Mikky100/ASkompu/docs/releases/0.1.2.md

# ASkompu 0.1.2 — Verified prototype

Release baseline: the latest implementation produced in the Codex conversation,
not the older 0.1.0 tree used accidentally for 0.1.1.

## Included GitHub issues

- #6: JAT+ULA/MLA first-interval timing at the accepted departure time
- #7: power button disabled by default for each session and display shutdown
- #8: trip presentation precision selected by speed with hysteresis
- #9: pulse input diagnostics, history and USB report
- #10: faster foot-reset response (5 ms software debounce)
- #11: one wrapping route-order continuation choice
- #12: move display shutdown to the main menu after System (sub-issue of #7)

The #7 shutdown placement is intentionally changed from the original issue:
`SAMMUTA NAYTTO` is the last main-menu item, immediately after `JARJESTELMA`.
Opening the main menu with Up selects it first. The button-settings submenu only
contains the session-local physical power-button enable/disable choice.

## Verification

- Native PlatformIO tests: 147/147 passed
- `esp32s3-ili9488-main`: build passed
- `lilygo-main`: build passed
- The ESP32-S3/ILI9488 version was installed through COM7; every written flash
  region was hash-verified by the upload tool and the device was reset cleanly
- The user confirmed that the installed version works on the target hardware

The Verified designation records the automated tests, successful release
builds, verified flash upload and hardware-functional confirmation above. It is
not a product-safety certification or a claim of a complete competition road
test.

Verified 8 November 2026.
