Mikky100/ASkompu/ASkompu_PCB_kytkentakaavio.png

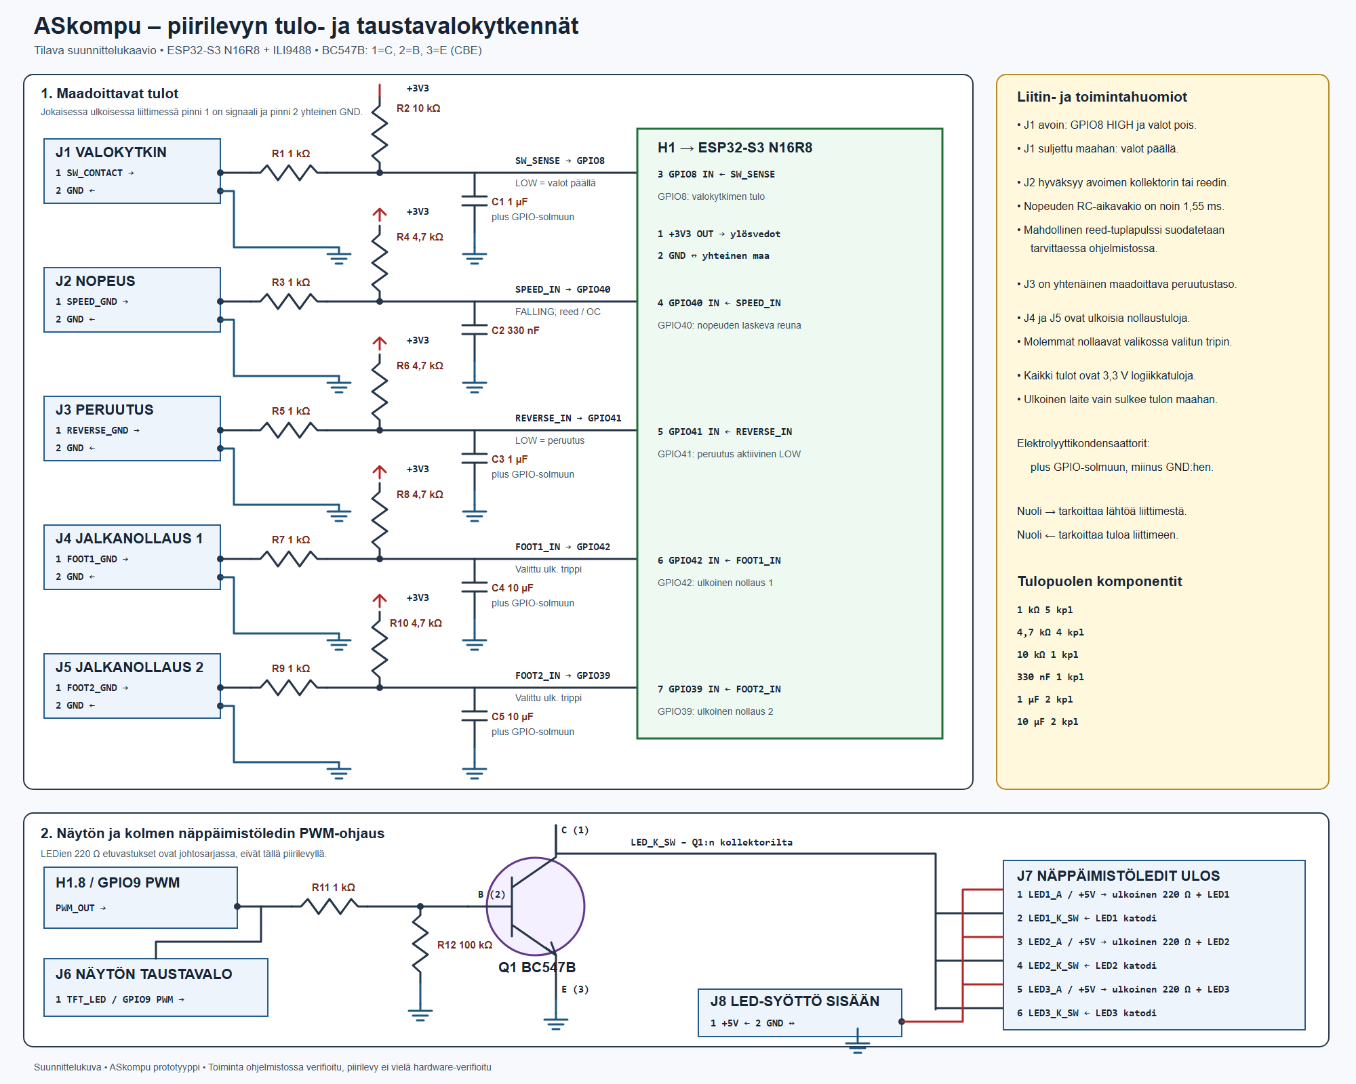
ASkompu_PCB_kytkentakaavio.png
