Mikky100/ASkompu/src/main.cpp

#include <Arduino.h>

#include "BoardConfig.h"
#include "CalibrationConfig.h"
#include "DemoConfig.h"
#include "core/ApplicationCore.h"
#include "input/DebouncedButton.h"
#include "input/PulseFilter.h"
#include "input/PulseInput.h"
#include "input/StableSignalFilter.h"
#include "ports/ArduinoClock.h"
#include "ports/PulseDiagnosticSerial.h"
#include "settings/SettingsRepository.h"
#include "settings/CompetitionProgressStore.h"
#include "settings/PreferencesRouteOrderStore.h"
#include "ui/DisplayView.h"

namespace {

constexpr uint32_t DEBOUNCE_MS = 12;
constexpr uint32_t FOOT_RESET_DEBOUNCE_MS = 5;
constexpr uint32_t POLL_INTERVAL_MS = 10;
constexpr uint32_t POINT_LONG_PRESS_MS = 2000;
constexpr uint32_t POINT_MINIMUM_PRESS_INTERVAL_MS = 500;
constexpr uint32_t REVERSE_STABILITY_MS = 20;
constexpr uint32_t LIGHT_SWITCH_STABILITY_MS = 20;
constexpr uint32_t RIGHT_MINIMUM_PRESS_INTERVAL_MS = 180;
constexpr uint32_t MAXIMUM_ACCEPTED_SPEED_KMH = 200;

input::DebouncedButton leftButton(BoardConfig::PIN_BUTTON_LEFT,
                                  BoardConfig::BUTTON_PRESSED_LEVEL,
                                  DEBOUNCE_MS,
                                  CalibrationConfig::LONG_PRESS_DELAY_MS);
input::DebouncedButton upButton(BoardConfig::PIN_BUTTON_UP,
                                BoardConfig::BUTTON_PRESSED_LEVEL,
                                DEBOUNCE_MS,
                                CalibrationConfig::LONG_PRESS_DELAY_MS,
                                CalibrationConfig::REPEAT_INTERVAL_MS);
input::DebouncedButton downButton(BoardConfig::PIN_BUTTON_DOWN,
                                  BoardConfig::BUTTON_PRESSED_LEVEL,
                                  DEBOUNCE_MS,
                                  CalibrationConfig::LONG_PRESS_DELAY_MS,
                                  CalibrationConfig::REPEAT_INTERVAL_MS);
input::DebouncedButton rightButton(BoardConfig::PIN_BUTTON_RIGHT,
                                   BoardConfig::BUTTON_PRESSED_LEVEL,
                                   DEBOUNCE_MS,
                                   CalibrationConfig::LONG_PRESS_DELAY_MS,
                                   0, RIGHT_MINIMUM_PRESS_INTERVAL_MS);
input::DebouncedButton pointButton(BoardConfig::PIN_BUTTON_POINT,
                                   BoardConfig::BUTTON_PRESSED_LEVEL,
                                   DEBOUNCE_MS, POINT_LONG_PRESS_MS, 0,
                                   POINT_MINIMUM_PRESS_INTERVAL_MS);
input::DebouncedButton atButton(BoardConfig::PIN_BUTTON_AT,
                                BoardConfig::BUTTON_PRESSED_LEVEL,
                                DEBOUNCE_MS);
input::DebouncedButton trip2ResetButton(BoardConfig::PIN_BUTTON_TRIP2_RESET,
                                        BoardConfig::BUTTON_PRESSED_LEVEL,
                                        DEBOUNCE_MS);
#ifdef ASKOMPU_HAS_TRIP1_RESET_PIN
input::DebouncedButton trip1ResetButton(BoardConfig::PIN_BUTTON_TRIP1_RESET,
                                        BoardConfig::BUTTON_PRESSED_LEVEL,
                                        DEBOUNCE_MS);
#endif
#ifdef ASKOMPU_HAS_FOOT_RESET_PIN
input::DebouncedButton footResetButton(BoardConfig::PIN_BUTTON_FOOT_RESET,
                                       BoardConfig::BUTTON_PRESSED_LEVEL,
                                       FOOT_RESET_DEBOUNCE_MS);
#endif
input::StableSignalFilter reverseFilter(REVERSE_STABILITY_MS);
#ifdef ASKOMPU_HAS_LIGHT_SWITCH_PIN
input::StableSignalFilter lightSwitchFilter(LIGHT_SWITCH_STABILITY_MS);
#endif
input::PulseInput pulseInput(BoardConfig::PIN_PULSE_INPUT,
                             BoardConfig::PULSE_INPUT_MODE,
                             BoardConfig::PULSE_INTERRUPT_MODE);

ports::ArduinoClock clockSource;
core::SoftwareClock softwareClock(clockSource);
core::ApplicationCore application(
    softwareClock, CalibrationConfig::DEFAULT_MILLIMETERS_PER_PULSE,
    DemoConfig::zeroSpeedTimeoutUs);
settings::SettingsRepository settingsRepository;
settings::CompetitionProgressStore competitionProgressStore;
settings::PreferencesRouteOrderStore routeOrderStore;
ui::DisplayView view;
uint32_t lastDisplayUpdateMs = 0;
core::Screen renderedScreen = core::Screen::StartupTimeEntry;
bool pointLongPressPending = false;
ports::PulseDiagnosticSerial pulseSerial;
bool serialResetRequested = false;
bool serialDumpRequested = false;

bool dispatchButton(input::DebouncedButton& button, core::ButtonId id,
                    uint32_t nowMs) {
  bool dispatched = false;
  if (button.consumePressedEvent()) {
    application.handleButton({id, core::ButtonEventType::Press, nowMs});
    dispatched = true;
  }
  if (button.consumeReleasedEvent()) {
    application.handleButton({id, core::ButtonEventType::Release, nowMs});
    dispatched = dispatched || id == core::ButtonId::At ||
                 application.screen() == core::Screen::Diagnostics;
  }
  if (button.consumeLongPressEvent()) {
    application.handleButton({id, core::ButtonEventType::LongStart, nowMs});
    dispatched = true;
  }
  if (button.consumeRepeatEvent()) {
    application.handleButton({id, core::ButtonEventType::LongRepeat, nowMs});
    dispatched = true;
  }
  return dispatched;
}

bool dispatchPointButton(uint32_t nowMs) {
  bool dispatched = false;
  if (pointButton.consumePressedEvent()) {
    pointLongPressPending = false;
    application.handleButton(
        {core::ButtonId::Point, core::ButtonEventType::Press, nowMs});
    dispatched = application.screen() == core::Screen::Diagnostics;
  }
  if (pointButton.consumeLongPressEvent()) {
    // Do not open the override menu while the contact is still held. Requiring
    // a stable release makes an additional-order request deliberate and keeps
    // a delayed/bounced normal point press from being interpreted as long.
    pointLongPressPending = true;
  }
  if (pointButton.consumeReleasedEvent()) {
    const bool shortPress = pointButton.consumeShortPressEvent();
    if (pointLongPressPending) {
      pointLongPressPending = false;
      application.handleButton(
          {core::ButtonId::Point, core::ButtonEventType::LongStart, nowMs});
      dispatched = true;
    } else if (shortPress) {
      application.handleButton(
          {core::ButtonId::Point, core::ButtonEventType::Release, nowMs});
      dispatched = true;
    }
  }
  return dispatched;
}

bool dispatchLeftButton(uint32_t nowMs) {
  bool dispatched = false;
  const bool diagnostics = application.screen() == core::Screen::Diagnostics;
  if (leftButton.consumePressedEvent() && diagnostics) {
    application.handleButton(
        {core::ButtonId::Left, core::ButtonEventType::Press, nowMs});
    dispatched = true;
  }
  if (leftButton.consumeLongPressEvent()) {
    application.handleButton(
        {core::ButtonId::Left, core::ButtonEventType::LongStart, nowMs});
    dispatched = true;
  }
  if (leftButton.consumeReleasedEvent()) {
    const bool shortPress = leftButton.consumeShortPressEvent();
    if (diagnostics) {
      application.handleButton(
          {core::ButtonId::Left, core::ButtonEventType::Release, nowMs});
      dispatched = true;
    } else if (shortPress) {
      application.handleButton(
          {core::ButtonId::Left, core::ButtonEventType::Press, nowMs});
      dispatched = true;
    }
  }
  return dispatched;
}

bool dispatchRightButton(uint32_t nowMs) {
  bool dispatched = false;
  const bool diagnostics = application.screen() == core::Screen::Diagnostics;
  if (rightButton.consumePressedEvent() && diagnostics) {
    application.handleButton({core::ButtonId::Right,
                              core::ButtonEventType::Press, nowMs});
    dispatched = true;
  }
  if (rightButton.consumeLongPressEvent()) {
    application.handleButton({core::ButtonId::Right,
                              core::ButtonEventType::LongStart, nowMs});
    dispatched = true;
  }
  if (rightButton.consumeReleasedEvent()) {
    const bool shortPress = rightButton.consumeShortPressEvent();
    if (diagnostics) {
      application.handleButton({core::ButtonId::Right,
                                core::ButtonEventType::Release, nowMs});
      dispatched = true;
    } else if (shortPress) {
      // Navigation is committed only after a complete, stable press/release.
      application.handleButton({core::ButtonId::Right,
                                core::ButtonEventType::Press, nowMs});
      dispatched = true;
    }
  }
  return dispatched;
}

}  // namespace

void setup() {
  Serial.begin(115200);
  Serial.printf("ASkompu 0.1.2 build %s %s\n", __DATE__, __TIME__);

  const settings::CalibrationLoadResult calibration =
      settingsRepository.loadCalibration();
  application.setInitialMillimetersPerPulse(calibration.millimetersPerPulse);
  pulseInput.setMinimumPulseIntervalUs(input::minimumPulseIntervalUs(
      calibration.millimetersPerPulse, MAXIMUM_ACCEPTED_SPEED_KMH));
  const settings::TextColorLoadResult textColor =
      settingsRepository.loadTextColor();
  application.setInitialTextColor(textColor.color);
  application.setCompetitionSettings(
      settingsRepository.loadCompetitionSettings().settings);
  application.setInitialDebugDisplaySettings(
      settingsRepository.loadDebugDisplaySettings().settings);
  application.setInitialDisplaySettings(
      settingsRepository.loadDisplaySettings().settings);
  Serial.printf("Calibration: %lu mm/pulse%s\n",
                static_cast<unsigned long>(calibration.millimetersPerPulse),
                calibration.usedDefault ? " (default)" : " (NVS)");
  domain::RouteOrder routeOrder;
  if (routeOrderStore.load(routeOrder)) {
    application.setInitialRouteOrder(
        routeOrder,
        routeOrderStore.activity() == route::RouteOrderActivity::ACTIVE);
    Serial.printf("Route order: %u segments (NVS)\n",
                  static_cast<unsigned>(routeOrder.segments.size()));
    domain::CompetitionProgressSnapshot progress;
    if (competitionProgressStore.load(progress))
      application.setInitialCompetitionProgress(progress);
  }

  leftButton.begin();
  upButton.begin();
  downButton.begin();
  rightButton.begin();
  pointButton.begin();
  atButton.begin();
  trip2ResetButton.begin();
#ifdef ASKOMPU_HAS_TRIP1_RESET_PIN
  trip1ResetButton.begin();
#endif
#ifdef ASKOMPU_HAS_FOOT_RESET_PIN
  footResetButton.begin();
#endif
#ifdef ASKOMPU_HAS_LIGHT_SWITCH_PIN
  pinMode(BoardConfig::PIN_LIGHT_SWITCH, BoardConfig::LIGHT_SWITCH_INPUT_MODE);
#endif
  pinMode(BoardConfig::PIN_REVERSE_INPUT, BoardConfig::REVERSE_INPUT_MODE);
  const uint32_t inputNowMs = clockSource.monotonicMilliseconds();
#ifdef ASKOMPU_HAS_LIGHT_SWITCH_PIN
  lightSwitchFilter.reset(
      digitalRead(BoardConfig::PIN_LIGHT_SWITCH) ==
          BoardConfig::LIGHT_SWITCH_ON_LEVEL,
      inputNowMs);
#endif
  reverseFilter.reset(
      digitalRead(BoardConfig::PIN_REVERSE_INPUT) ==
          BoardConfig::REVERSE_ACTIVE_LEVEL,
      inputNowMs);
  application.handleReverseSignal({reverseFilter.active(), inputNowMs});
  pulseInput.begin();

  const bool displayReady = view.begin();
#ifdef ASKOMPU_HAS_LIGHT_SWITCH_PIN
  view.setBacklight(application.displayOn());
#endif
#if defined(TFT_BL) && defined(TFT_BACKLIGHT_ON)
  Serial.printf("Display: buffer=%s, backlight GPIO%u=%s (read=%u)\n",
                displayReady ? "ok" : "failed",
                static_cast<unsigned>(TFT_BL),
                TFT_BACKLIGHT_ON == HIGH ? "active HIGH" : "active LOW",
                static_cast<unsigned>(digitalRead(TFT_BL)));
#else
  Serial.printf("Display: buffer=%s, no backlight GPIO\n",
                displayReady ? "ok" : "failed");
#endif
  view.render(application.displayModel());
}

void loop() {
  const uint32_t nowMs = clockSource.monotonicMilliseconds();

  leftButton.update(nowMs);
  upButton.update(nowMs);
  downButton.update(nowMs);
  rightButton.update(nowMs);
  pointButton.update(nowMs);
  atButton.update(nowMs);
  trip2ResetButton.update(nowMs);
#ifdef ASKOMPU_HAS_TRIP1_RESET_PIN
  trip1ResetButton.update(nowMs);
#endif
#ifdef ASKOMPU_HAS_FOOT_RESET_PIN
  footResetButton.update(nowMs);
#endif

#ifdef ASKOMPU_HAS_LIGHT_SWITCH_PIN
  const bool rawLightsEnabled =
      digitalRead(BoardConfig::PIN_LIGHT_SWITCH) ==
      BoardConfig::LIGHT_SWITCH_ON_LEVEL;
  if (lightSwitchFilter.update(rawLightsEnabled, nowMs))
    application.handleLightSwitch(lightSwitchFilter.active());
#endif

  if (leftButton.isPressed() || upButton.isPressed() || downButton.isPressed() ||
      rightButton.isPressed() || pointButton.isPressed() || atButton.isPressed() ||
      trip2ResetButton.isPressed()
#ifdef ASKOMPU_HAS_TRIP1_RESET_PIN
      || trip1ResetButton.isPressed()
#endif
#ifdef ASKOMPU_HAS_FOOT_RESET_PIN
      || footResetButton.isPressed()
#endif
      )
    application.wakeDisplay();

  const bool rawReverse =
      digitalRead(BoardConfig::PIN_REVERSE_INPUT) ==
      BoardConfig::REVERSE_ACTIVE_LEVEL;
  if (reverseFilter.update(rawReverse, nowMs))
    application.handleReverseSignal({reverseFilter.active(), nowMs});

  for (uint8_t index = 0; index < 8 && Serial.available(); ++index) {
    const char command = Serial.read();
    if (command == 'p') serialDumpRequested = true;
    if (command == 'r') serialResetRequested = true;
  }
  const bool resetDiagnostics =
      serialResetRequested || application.takePulseDiagnosticsResetRequest();
  serialResetRequested = false;
  if (resetDiagnostics) pulseSerial.cancel();
  const input::PulseSnapshot pulseSnapshot =
      pulseInput.consumeSnapshot(resetDiagnostics);
  const uint32_t nowUs = clockSource.monotonicMicroseconds();

  bool inputDispatched = false;
  inputDispatched |= dispatchLeftButton(nowMs);
  inputDispatched |= dispatchButton(upButton, core::ButtonId::Up, nowMs);
  inputDispatched |= dispatchButton(downButton, core::ButtonId::Down, nowMs);
  inputDispatched |= dispatchRightButton(nowMs);
  inputDispatched |= dispatchPointButton(nowMs);
  inputDispatched |= dispatchButton(atButton, core::ButtonId::At, nowMs);
  inputDispatched |=
      dispatchButton(trip2ResetButton, core::ButtonId::Trip2Reset, nowMs);
#ifdef ASKOMPU_HAS_TRIP1_RESET_PIN
  inputDispatched |=
      dispatchButton(trip1ResetButton, core::ButtonId::Trip1Reset, nowMs);
#endif
#ifdef ASKOMPU_HAS_FOOT_RESET_PIN
  inputDispatched |=
      dispatchButton(footResetButton, core::ButtonId::FootReset, nowMs);
#endif

  application.handleDistancePulses(
      {pulseSnapshot.pendingPulses, pulseSnapshot.previousPulseAtUs,
       pulseSnapshot.lastPulseAtUs, nowUs, reverseFilter.active()});
  if (!resetDiagnostics)
    pulseInput.recordDelivered(pulseSnapshot.pendingPulses);
  application.tick(nowUs);
  if (serialDumpRequested || application.takePulseDiagnosticsDumpRequest()) {
    serialDumpRequested = false;
    pulseSerial.capture(
        pulseInput, application.millimetersPerPulse(),
        BoardConfig::PIN_PULSE_INPUT,
        BoardConfig::PULSE_INTERRUPT_MODE == FALLING);
  }
  pulseSerial.service();
  const input::PulseDiagnosticsSnapshot pulseDiagnostics =
      pulseInput.diagnostics();
  application.setPulseDiagnostics(
      pulseDiagnostics,
      pulseDiagnostics.hasAccepted
          ? micros() - pulseDiagnostics.lastAcceptedUs
          : 0,
      BoardConfig::PIN_PULSE_INPUT,
      BoardConfig::PULSE_INTERRUPT_MODE == FALLING);

  bool progressRestored = false;
  if (application.takeCompetitionProgressRestoreResult(progressRestored))
    Serial.printf("Competition progress restore: %s\n",
                  progressRestored ? "ok" : "rejected; started from route");

  uint32_t calibrationToSave = 0;
  if (application.takeCalibrationSaveRequest(calibrationToSave)) {
    const bool saved = settingsRepository.saveCalibration(calibrationToSave);
    application.completeCalibrationSave(saved);
    if (saved) {
      pulseInput.setMinimumPulseIntervalUs(input::minimumPulseIntervalUs(
          calibrationToSave, MAXIMUM_ACCEPTED_SPEED_KMH));
      Serial.printf("Saved calibration: %lu mm/pulse\n",
                    static_cast<unsigned long>(calibrationToSave));
    }
  }

  domain::TextColor textColorToSave = domain::TextColor::WHITE;
  if (application.takeTextColorSaveRequest(textColorToSave)) {
    application.completeTextColorSave(
        settingsRepository.saveTextColor(textColorToSave));
  }

  domain::DebugDisplaySettings debugSettingsToSave;
  if (application.takeDebugDisplaySettingsSaveRequest(debugSettingsToSave)) {
    application.completeDebugDisplaySettingsSave(
        settingsRepository.saveDebugDisplaySettings(debugSettingsToSave));
  }

  domain::DisplaySettings displaySettingsToSave;
  if (application.takeDisplaySettingsSaveRequest(displaySettingsToSave)) {
    application.completeDisplaySettingsSave(
        settingsRepository.saveDisplaySettings(displaySettingsToSave));
  }

  const domain::RouteOrder* orderToSave = nullptr;
  if (application.takeRouteOrderSaveRequest(orderToSave)) {
    const bool saved = orderToSave && routeOrderStore.replace(*orderToSave);
    application.completeRouteOrderSave(saved);
    Serial.printf("Route order save: %s\n", saved ? "ok" : "failed");
  }
  if (application.takeRouteOrderCompletionRequest()) {
    application.completeRouteOrderCompletion(routeOrderStore.markCompleted());
  }
  if (application.takeCompetitionProgressClearRequest())
    competitionProgressStore.clear();
  domain::CompetitionProgressSnapshot progress;
  if (application.takeCompetitionProgressSaveRequest(progress))
    competitionProgressStore.save(progress);

  const core::DisplayModel displayModel = application.displayModel();
  view.setBacklight(displayModel.displayOn);
  const bool screenChanged = displayModel.screen != renderedScreen;
  const bool periodicScreen =
      displayModel.screen == core::Screen::BasicView ||
      displayModel.screen == core::Screen::JatResult ||
      displayModel.screen == core::Screen::StartTimeEdit ||
      displayModel.screen == core::Screen::Diagnostics ||
      displayModel.screen == core::Screen::PulseDiagnostics;
  const uint32_t periodicIntervalMs =
      (displayModel.screen == core::Screen::Diagnostics ||
       displayModel.screen == core::Screen::PulseDiagnostics)
          ? 2000UL
          : BoardConfig::DISPLAY_UPDATE_INTERVAL_MS;
  if (inputDispatched || screenChanged ||
      (periodicScreen &&
       nowMs - lastDisplayUpdateMs >= periodicIntervalMs)) {
    view.render(displayModel);
    renderedScreen = displayModel.screen;
    lastDisplayUpdateMs = nowMs;
  }
  delay(POLL_INTERVAL_MS);
}
