Mikky100/ASkompu/src/domain/MotionMath.cpp

#include "MotionMath.h"

#include <limits>

namespace domain {
namespace motion {

uint64_t distanceMillimetersForPulses(uint32_t pulses,
                                      uint32_t millimetersPerPulse) {
  return static_cast<uint64_t>(pulses) *
         static_cast<uint64_t>(millimetersPerPulse);
}

uint64_t saturatingAdd(uint64_t current, uint64_t increment) {
  const uint64_t maximum = std::numeric_limits<uint64_t>::max();
  return increment > maximum - current ? maximum : current + increment;
}

int64_t saturatingAddSigned(int64_t current, int64_t delta) {
  if (delta > 0 && current > std::numeric_limits<int64_t>::max() - delta)
    return std::numeric_limits<int64_t>::max();
  if (delta < 0 && current < std::numeric_limits<int64_t>::min() - delta)
    return std::numeric_limits<int64_t>::min();
  return current + delta;
}

float speedKmhFromPulseInterval(uint32_t millimetersPerPulse,
                                uint32_t intervalUs) {
  if (intervalUs == 0) {
    return 0.0F;
  }
  return static_cast<float>(millimetersPerPulse) * 3600.0F /
         static_cast<float>(intervalUs);
}

bool elapsedAtLeast(uint32_t now, uint32_t since, uint32_t duration) {
  return now - since >= duration;
}

}  // namespace motion
}  // namespace domain
