Mikky100/ASkompu/src/settings/SettingsRepository.cpp

#include "SettingsRepository.h"

#include <Preferences.h>

#include "CalibrationConfig.h"
#include "domain/CalibrationSetting.h"

namespace settings {
namespace {

constexpr char PREFERENCES_NAMESPACE[] = "askompu";
constexpr char SCHEMA_VERSION_KEY[] = "schemaVersion";
constexpr char CALIBRATION_KEY[] = "mmPerPulseFixed";
constexpr char TEXT_COLOR_KEY[] = "textColor";
constexpr char LATE_FACTOR_KEY[] = "lateFactor";
constexpr char EARLY_FACTOR_KEY[] = "earlyFactor";
constexpr char JAT_RESULT_SECONDS_KEY[] = "jatResultSec";
constexpr char AT_DISPLAY_DISTANCE_KEY[] = "atDistanceM";
constexpr char DEBUG_DISPLAY_ELEMENTS_KEY[] = "debugDisplay";
constexpr char BACKLIGHT_PERCENT_KEY[] = "backlight";
constexpr char SHOW_LABELS_KEY[] = "showLabels";
constexpr char MENU_FONT_SIZE_KEY[] = "menuFont";
constexpr char TRIP_DISPLAY_MODE_KEY[] = "tripDisplay";
constexpr char EXTERNAL_RESET_TARGET_KEY[] = "extTripReset";
constexpr char INTERNAL_RESET_TARGET_KEY[] = "intTripReset";

}  // namespace

CalibrationLoadResult SettingsRepository::loadCalibration() const {
  Preferences preferences;
  if (!preferences.begin(PREFERENCES_NAMESPACE, true)) {
    return {CalibrationConfig::DEFAULT_MILLIMETERS_PER_PULSE, true};
  }

  const uint16_t schemaVersion = preferences.getUShort(SCHEMA_VERSION_KEY, 0);
  const uint32_t storedValue = preferences.getUInt(CALIBRATION_KEY, 0);
  preferences.end();

  const bool valid =
      (schemaVersion == 1 || schemaVersion == 2 ||
       schemaVersion == CalibrationConfig::SETTINGS_SCHEMA_VERSION) &&
      domain::calibration::isValid(storedValue);
  return {valid ? storedValue
                : CalibrationConfig::DEFAULT_MILLIMETERS_PER_PULSE,
          !valid};
}

TextColorLoadResult SettingsRepository::loadTextColor() const {
  Preferences preferences;
  if (!preferences.begin(PREFERENCES_NAMESPACE, true)) {
    return {domain::TextColor::WHITE, true};
  }
  const uint16_t schemaVersion = preferences.getUShort(SCHEMA_VERSION_KEY, 0);
  const domain::TextColor color = static_cast<domain::TextColor>(
      preferences.getUChar(TEXT_COLOR_KEY,
                           static_cast<uint8_t>(domain::TextColor::WHITE)));
  preferences.end();
  const bool valid =
      (schemaVersion == 2 ||
       schemaVersion == CalibrationConfig::SETTINGS_SCHEMA_VERSION) &&
      domain::isValidTextColor(color);
  return {valid ? color : domain::TextColor::WHITE, !valid};
}

bool SettingsRepository::saveTextColor(domain::TextColor color) const {
  if (!domain::isValidTextColor(color)) return false;
  Preferences preferences;
  if (!preferences.begin(PREFERENCES_NAMESPACE, false)) return false;
  const bool schemaWritten =
      preferences.putUShort(SCHEMA_VERSION_KEY,
                            CalibrationConfig::SETTINGS_SCHEMA_VERSION) ==
      sizeof(uint16_t);
  const bool colorWritten =
      preferences.putUChar(TEXT_COLOR_KEY, static_cast<uint8_t>(color)) ==
      sizeof(uint8_t);
  preferences.end();
  return schemaWritten && colorWritten;
}

bool SettingsRepository::saveCalibration(uint32_t millimetersPerPulse) const {
  if (!domain::calibration::isValid(millimetersPerPulse)) {
    return false;
  }

  Preferences preferences;
  if (!preferences.begin(PREFERENCES_NAMESPACE, false)) {
    return false;
  }

  const bool alreadyStored =
      preferences.getUShort(SCHEMA_VERSION_KEY, 0) ==
          CalibrationConfig::SETTINGS_SCHEMA_VERSION &&
      preferences.getUInt(CALIBRATION_KEY, 0) == millimetersPerPulse;
  if (alreadyStored) {
    preferences.end();
    return true;
  }

  const bool schemaWritten =
      preferences.putUShort(SCHEMA_VERSION_KEY,
                            CalibrationConfig::SETTINGS_SCHEMA_VERSION) ==
      sizeof(uint16_t);
  const bool calibrationWritten =
      preferences.putUInt(CALIBRATION_KEY, millimetersPerPulse) ==
      sizeof(uint32_t);
  preferences.end();
  return schemaWritten && calibrationWritten;
}

CompetitionSettingsLoadResult SettingsRepository::loadCompetitionSettings()
    const {
  Preferences preferences;
  if (!preferences.begin(PREFERENCES_NAMESPACE, true))
    return {domain::CompetitionSettings{}, true};
  const uint16_t schemaVersion = preferences.getUShort(SCHEMA_VERSION_KEY, 0);
  domain::CompetitionSettings loaded;
  bool usedDefault = schemaVersion != CalibrationConfig::SETTINGS_SCHEMA_VERSION;
  if (!usedDefault) {
    loaded.lateFactor = preferences.getUShort(LATE_FACTOR_KEY, 1);
    loaded.earlyFactor = preferences.getUShort(EARLY_FACTOR_KEY, 3);
    loaded.jatResultSeconds = preferences.getUChar(JAT_RESULT_SECONDS_KEY, 5);
    loaded.atDisplayDistanceM =
        preferences.getUChar(AT_DISPLAY_DISTANCE_KEY, 10);
  }
  preferences.end();
  const domain::CompetitionSettings validated =
      domain::validatedCompetitionSettings(loaded);
  usedDefault = usedDefault || validated.lateFactor != loaded.lateFactor ||
                validated.earlyFactor != loaded.earlyFactor ||
                validated.jatResultSeconds != loaded.jatResultSeconds ||
                validated.atDisplayDistanceM != loaded.atDisplayDistanceM;
  return {validated, usedDefault};
}

bool SettingsRepository::saveCompetitionSettings(
    const domain::CompetitionSettings& settings) const {
  const domain::CompetitionSettings validated =
      domain::validatedCompetitionSettings(settings);
  if (validated.lateFactor != settings.lateFactor ||
      validated.earlyFactor != settings.earlyFactor ||
      validated.jatResultSeconds != settings.jatResultSeconds ||
      validated.atDisplayDistanceM != settings.atDisplayDistanceM)
    return false;
  Preferences preferences;
  if (!preferences.begin(PREFERENCES_NAMESPACE, false)) return false;
  bool ok = true;
  if (preferences.getUShort(SCHEMA_VERSION_KEY, 0) !=
      CalibrationConfig::SETTINGS_SCHEMA_VERSION)
    ok = preferences.putUShort(SCHEMA_VERSION_KEY,
                               CalibrationConfig::SETTINGS_SCHEMA_VERSION) ==
         sizeof(uint16_t);
  if (ok && preferences.getUShort(LATE_FACTOR_KEY, 0) != validated.lateFactor)
    ok = preferences.putUShort(LATE_FACTOR_KEY, validated.lateFactor) ==
         sizeof(uint16_t);
  if (ok && preferences.getUShort(EARLY_FACTOR_KEY, 0) != validated.earlyFactor)
    ok = preferences.putUShort(EARLY_FACTOR_KEY, validated.earlyFactor) ==
         sizeof(uint16_t);
  if (ok && preferences.getUChar(JAT_RESULT_SECONDS_KEY, 0xFF) !=
                validated.jatResultSeconds)
    ok = preferences.putUChar(JAT_RESULT_SECONDS_KEY,
                              validated.jatResultSeconds) == sizeof(uint8_t);
  if (ok && preferences.getUChar(AT_DISPLAY_DISTANCE_KEY, 0xFF) !=
                validated.atDisplayDistanceM)
    ok = preferences.putUChar(AT_DISPLAY_DISTANCE_KEY,
                              validated.atDisplayDistanceM) == sizeof(uint8_t);
  preferences.end();
  return ok;
}

DebugDisplaySettingsLoadResult SettingsRepository::loadDebugDisplaySettings()
    const {
  Preferences preferences;
  if (!preferences.begin(PREFERENCES_NAMESPACE, true))
    return {domain::DebugDisplaySettings{}, true};
  const uint16_t schemaVersion = preferences.getUShort(SCHEMA_VERSION_KEY, 0);
  const uint16_t stored =
      preferences.getUShort(DEBUG_DISPLAY_ELEMENTS_KEY, 0);
  preferences.end();
  domain::DebugDisplaySettings raw{stored};
  const domain::DebugDisplaySettings validated =
      domain::validatedDebugDisplaySettings(raw);
  const bool validSchema =
      schemaVersion == CalibrationConfig::SETTINGS_SCHEMA_VERSION;
  return {validSchema ? validated : domain::DebugDisplaySettings{},
          !validSchema || validated.enabledElements != raw.enabledElements};
}

bool SettingsRepository::saveDebugDisplaySettings(
    const domain::DebugDisplaySettings& settings) const {
  const domain::DebugDisplaySettings validated =
      domain::validatedDebugDisplaySettings(settings);
  if (validated.enabledElements != settings.enabledElements) return false;
  Preferences preferences;
  if (!preferences.begin(PREFERENCES_NAMESPACE, false)) return false;
  const bool alreadyStored =
      preferences.getUShort(SCHEMA_VERSION_KEY, 0) ==
          CalibrationConfig::SETTINGS_SCHEMA_VERSION &&
      preferences.getUShort(DEBUG_DISPLAY_ELEMENTS_KEY, 0) ==
          validated.enabledElements;
  if (alreadyStored) {
    preferences.end();
    return true;
  }
  bool ok = preferences.putUShort(SCHEMA_VERSION_KEY,
                                  CalibrationConfig::SETTINGS_SCHEMA_VERSION) ==
            sizeof(uint16_t);
  if (ok)
    ok = preferences.putUShort(DEBUG_DISPLAY_ELEMENTS_KEY,
                               validated.enabledElements) == sizeof(uint16_t);
  preferences.end();
  return ok;
}

DisplaySettingsLoadResult SettingsRepository::loadDisplaySettings() const {
  Preferences preferences;
  if (!preferences.begin(PREFERENCES_NAMESPACE, true))
    return {domain::DisplaySettings{}, true};
  const bool validSchema =
      preferences.getUShort(SCHEMA_VERSION_KEY, 0) ==
      CalibrationConfig::SETTINGS_SCHEMA_VERSION;
  domain::DisplaySettings loaded;
  loaded.backlightPercent = preferences.getUChar(
      BACKLIGHT_PERCENT_KEY, domain::DEFAULT_BACKLIGHT_PERCENT);
  loaded.showLabels = preferences.getBool(SHOW_LABELS_KEY, true);
  loaded.menuFontSize = static_cast<domain::MenuFontSize>(preferences.getUChar(
      MENU_FONT_SIZE_KEY,
      static_cast<uint8_t>(domain::MenuFontSize::MEDIUM)));
  loaded.tripDisplayMode = static_cast<domain::TripDisplayMode>(
      preferences.getUChar(
          TRIP_DISPLAY_MODE_KEY,
          static_cast<uint8_t>(domain::TripDisplayMode::TRIP_1)));
  loaded.externalResetTarget = static_cast<domain::TripResetTarget>(
      preferences.getUChar(
          EXTERNAL_RESET_TARGET_KEY,
          static_cast<uint8_t>(domain::TripResetTarget::TRIP_1)));
  loaded.internalResetTarget = static_cast<domain::TripResetTarget>(
      preferences.getUChar(
          INTERNAL_RESET_TARGET_KEY,
          static_cast<uint8_t>(domain::TripResetTarget::TRIP_1)));
  preferences.end();
  const domain::DisplaySettings validated =
      domain::validatedDisplaySettings(loaded);
  return {validSchema ? validated : domain::DisplaySettings{},
          !validSchema || !domain::isValidDisplaySettings(loaded)};
}

bool SettingsRepository::saveDisplaySettings(
    const domain::DisplaySettings& settings) const {
  if (!domain::isValidDisplaySettings(settings)) return false;
  Preferences preferences;
  if (!preferences.begin(PREFERENCES_NAMESPACE, false)) return false;
  bool ok = true;
  if (preferences.getUShort(SCHEMA_VERSION_KEY, 0) !=
      CalibrationConfig::SETTINGS_SCHEMA_VERSION)
    ok = preferences.putUShort(SCHEMA_VERSION_KEY,
                               CalibrationConfig::SETTINGS_SCHEMA_VERSION) ==
         sizeof(uint16_t);
  if (ok && preferences.getUChar(BACKLIGHT_PERCENT_KEY, 0xFF) !=
                settings.backlightPercent)
    ok = preferences.putUChar(BACKLIGHT_PERCENT_KEY,
                              settings.backlightPercent) == sizeof(uint8_t);
  if (ok && preferences.getBool(SHOW_LABELS_KEY, !settings.showLabels) !=
                settings.showLabels)
    ok = preferences.putBool(SHOW_LABELS_KEY, settings.showLabels) ==
         sizeof(bool);
  if (ok && preferences.getUChar(MENU_FONT_SIZE_KEY, 0xFF) !=
                static_cast<uint8_t>(settings.menuFontSize))
    ok = preferences.putUChar(MENU_FONT_SIZE_KEY,
                              static_cast<uint8_t>(settings.menuFontSize)) ==
         sizeof(uint8_t);
  if (ok && preferences.getUChar(TRIP_DISPLAY_MODE_KEY, 0xFF) !=
                static_cast<uint8_t>(settings.tripDisplayMode))
    ok = preferences.putUChar(
             TRIP_DISPLAY_MODE_KEY,
             static_cast<uint8_t>(settings.tripDisplayMode)) == sizeof(uint8_t);
  if (ok && preferences.getUChar(EXTERNAL_RESET_TARGET_KEY, 0xFF) !=
                static_cast<uint8_t>(settings.externalResetTarget))
    ok = preferences.putUChar(
             EXTERNAL_RESET_TARGET_KEY,
             static_cast<uint8_t>(settings.externalResetTarget)) ==
         sizeof(uint8_t);
  if (ok && preferences.getUChar(INTERNAL_RESET_TARGET_KEY, 0xFF) !=
                static_cast<uint8_t>(settings.internalResetTarget))
    ok = preferences.putUChar(
             INTERNAL_RESET_TARGET_KEY,
             static_cast<uint8_t>(settings.internalResetTarget)) ==
         sizeof(uint8_t);
  preferences.end();
  return ok;
}

}  // namespace settings
