Mikky100/ASkompu/src/settings/PreferencesRouteOrderStore.h

#pragma once

#include "route/RouteOrderStore.h"

namespace settings {

class PreferencesRouteOrderStore : public route::RouteOrderStore {
 public:
  bool load(domain::RouteOrder& order) override;
  bool replace(const domain::RouteOrder& validatedOrder) override;
  bool clear() override;
  route::RouteOrderActivity activity() override;
  bool markCompleted() override;
};

}  // namespace settings
