Mikky100/ASkompu/src/ui/DisplayView.h

#pragma once

#include <Arduino.h>
#include <TFT_eSPI.h>

#include "core/DisplayModel.h"
#include "DisplayPort.h"

namespace ui {

class DisplayView : public DisplayPort {
 public:
  DisplayView();
  bool begin() override;
  void setBacklight(bool enabled) override;
  void setBacklightPercent(uint8_t percent);
  uint16_t width() const override;
  uint16_t height() const override;
  void render(const core::DisplayModel& model) override;

 private:
  void showBasicView(const core::DisplayModel& model);
  void showTimeEntry(const core::TimeEntryDisplayModel& model);
  void showMenu(const core::MenuDisplayModel& model);
  void showCalibration(const core::CalibrationDisplayModel& model);
  void showMittis(const core::MittisDisplayModel& model);
  void showJatResult(const core::JatResultDisplayModel& model);
  void showFinishResult(const core::FinishResultDisplayModel& model);
  void showStartTimeEdit(const core::StartTimeEditDisplayModel& model);
  void showOverrideMenu(const core::OverrideMenuDisplayModel& model);
  void showOverrideEdit(const core::OverrideEditDisplayModel& model);
  void showResultView(const core::ResultViewDisplayModel& model);
  void showOrderAccess(const core::OrderAccessDisplayModel& model);
  void showOrder(const core::OrderDisplayModel& model);
  void showPulseDiagnostics(const core::DisplayModel& model);
  void showDiagnostics(const core::DiagnosticsDisplayModel& model);
  void drawFooter(const char* left, const char* upDown, const char* right,
                  uint16_t color);

  TFT_eSPI display_;
  TFT_eSprite canvas_;
  core::DisplayModel lastModel_{};
  core::Screen renderedScreen_ = core::Screen::StartupTimeEntry;
  uint32_t menuTitleFingerprint_ = 0;
  uint32_t menuRowsFingerprint_ = 0;
  uint16_t textColor_ = TFT_WHITE;
  uint8_t backlightPercent_ = domain::DEFAULT_BACKLIGHT_PERCENT;
  domain::MenuFontSize menuFontSize_ = domain::MenuFontSize::MEDIUM;
  bool backlightEnabled_ = true;
  bool showLabels_ = true;
  bool spriteReady_ = false;
  bool hasRendered_ = false;
};

}  // namespace ui
