Mikky100/ASkompu/src/ui/RouteOrderFormatting.h

#pragma once

#include <cstddef>

#include "route/RouteOrderEditor.h"

namespace ui {

const char* routeOrderEditorTitle(const route::RouteOrderEditorView& editor);
const char* competitionTypeLabel(domain::CompetitionType competitionType);
void formatEditableRouteOrderValue(
    char* text, std::size_t size,
    const route::RouteOrderEditorView& editor);
void formatDriveSegmentRange(char* text, std::size_t size,
                             const domain::SegmentDefinition& segment);
const char* driveSegmentLabel(const domain::SegmentDefinition& segment);

}  // namespace ui
