Mikky100/ASkompu/(commit log)

2026-07-15 Add initial LilyGO button demo
2026-07-15 Add calibrated Trip 1 distance display
2026-07-15 Add persistent pulse calibration
2026-07-17 Add ESP32-S3 ILI9488 board profile
2026-07-18 fix input and competition display regressions
    [ApplicationCore.cpp, ApplicationCore.h, ButtonInterpreter.cpp, ButtonInterpreter.h, DisplayView.cpp, DisplayView.h, Esp32S3Ili9488Config.h]
2026-07-20 Prepare 0.1.0 prototype release
2026-08-01 Update prototype controls and electronics (#5)
    Ensimmäinen autossa testattu prototyyppi.
2026-11-06 Release 0.1.1 verified prototype with issues 6-9
2026-11-08 Release 0.1.2 verified prototype
